hobbitronics/DeLonghi-Dedica-EC885-EC685-modification/images/1.jpg

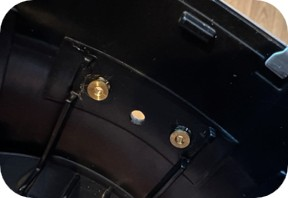
images/1.jpg
