hobbitronics/DeLonghi-Dedica-EC885-EC685-modification/(commit log)

2025-11-29 add my own vibe source code (with 1.6 Mpa p sensor)
2025-11-29 add "Mounting the Arduino" section to README
2025-11-29 adjust start for retained pressure, bigger font
2025-11-29 fix start stop scale bug
    [dedica_nano.ino]
2025-11-30 less samples, fix shot end bar
    [dedica_nano.ino]
2025-11-30 fix shot ending during pre-infusion and p/10 bugs
    [dedica_nano.ino]
2025-12-07 increase samples and improve readability a little
2025-12-07 add comments, reset last_below_ms
    [dedica_nano.ino]
2025-12-15 move dedica_nano.ino to src/arduino
2025-12-15 add esp32 for espHome code
2025-12-17 add pressure smoothing
2025-12-17 add temperature smoothing
